FreshView/FreshView/README.md

# FreshView
Automated Plant Monitoring system
