FreshView/FreshView/Documentation/SympsosiumPosterFinal.pdf

# Hardware

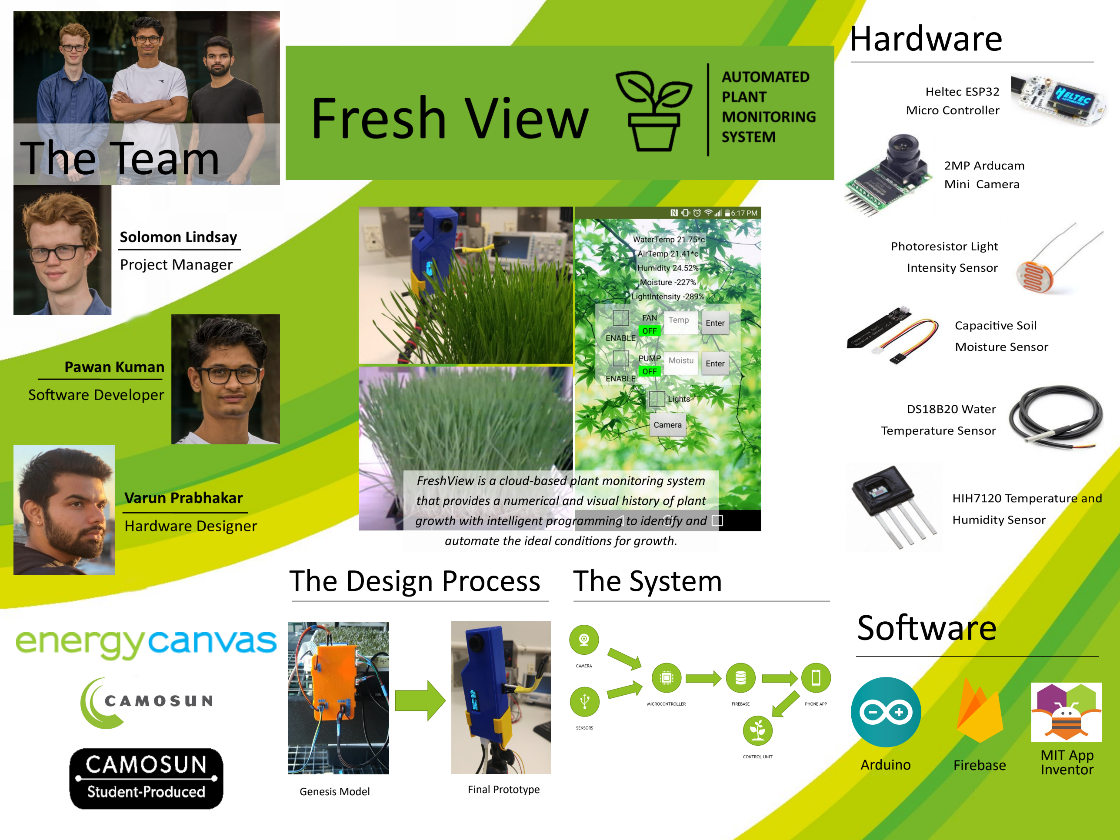
[picture p22: page 1]

# The Design Process

Genesis Model | Final Prototype

# Software

Arduino Firebase

MIT App
Inventor

# The System
