FreshView/FreshView/Documentation/FreshViewFinalPresentation.pdf

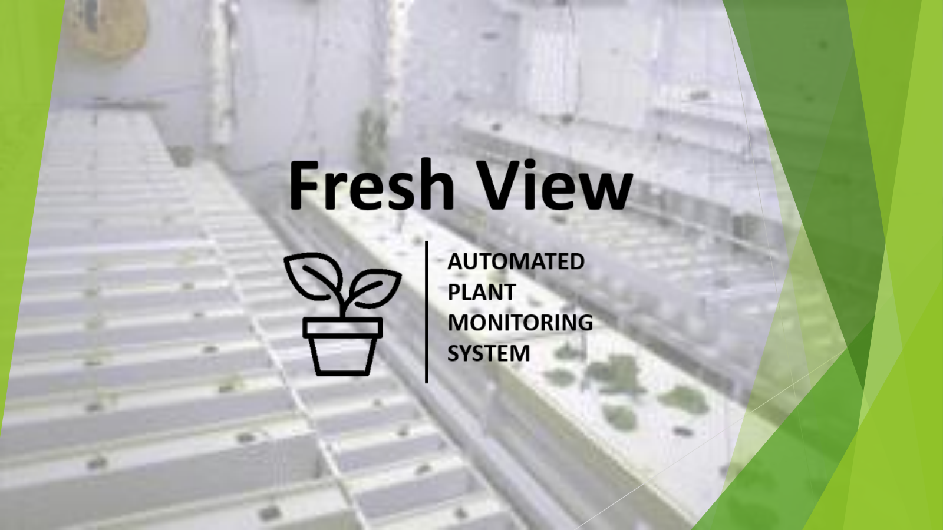
[picture p23: page 1]

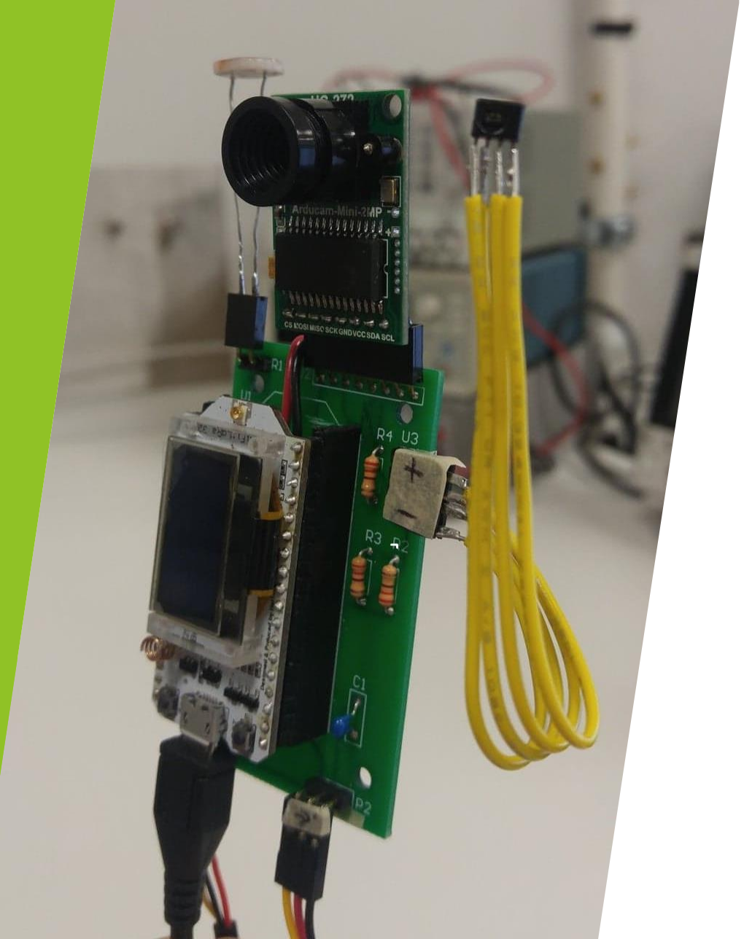
[picture p24: figure]

# The Project

Fresh View is a cloud-based plant monitoring system that provides numerical and visual data of plant growth to identify and automate the ideal growing conditions.

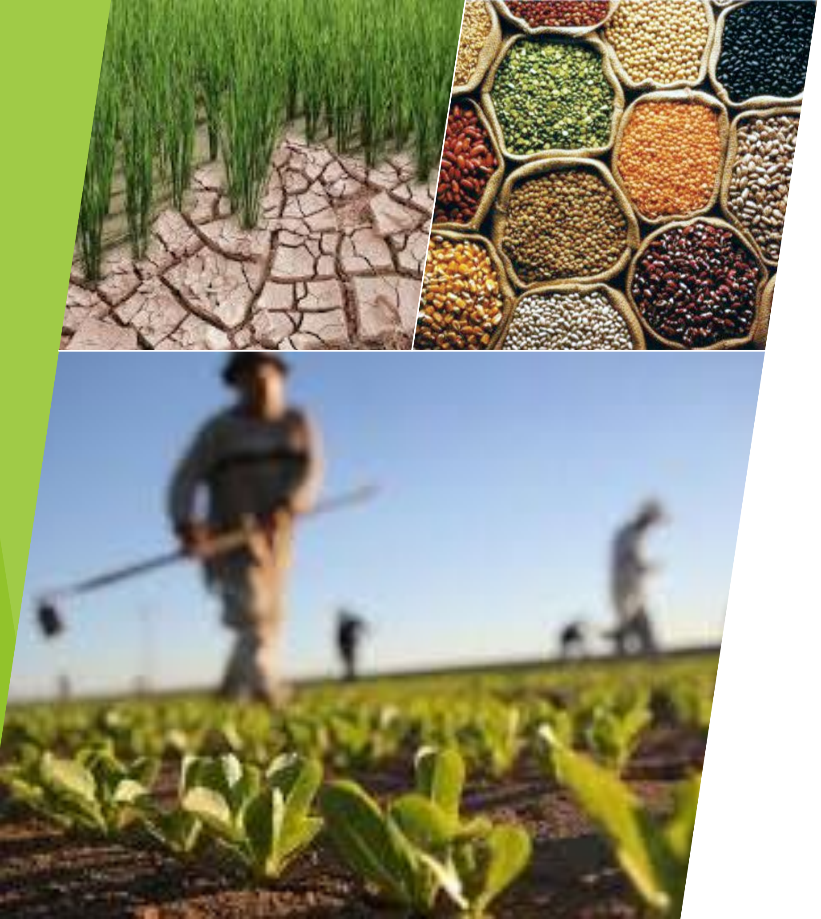
[picture p25: figure]
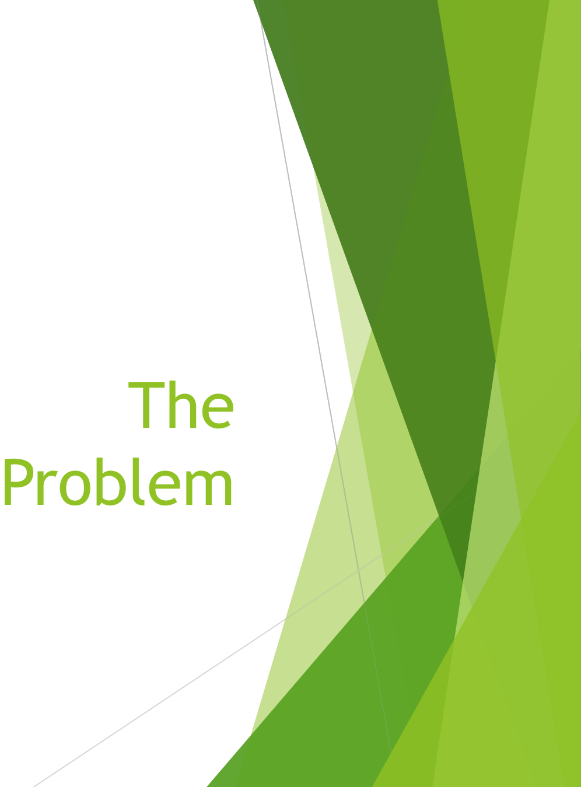
[picture p26: figure]
The Problem

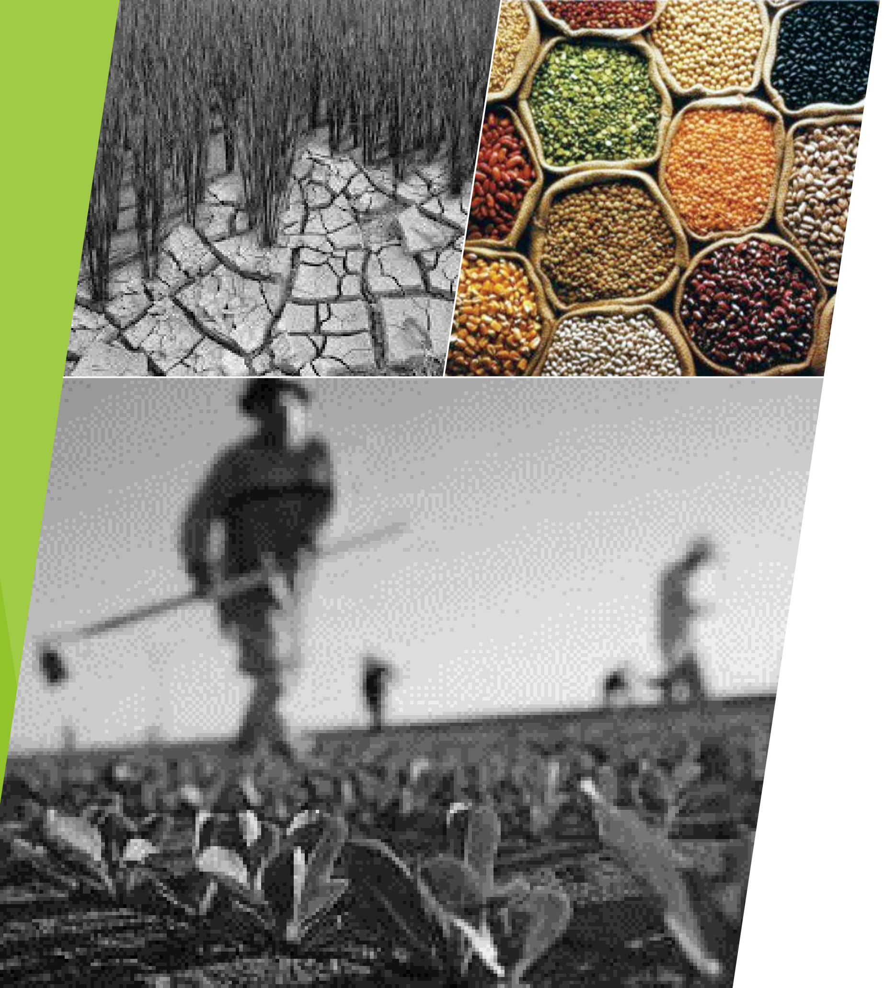
[picture p27: figure]

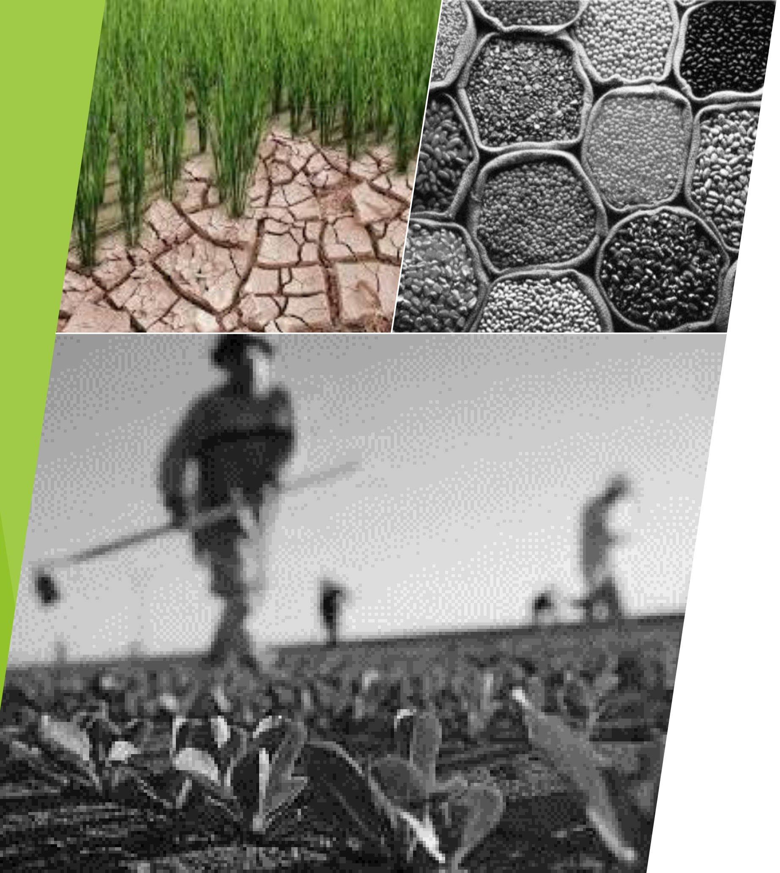
[picture p28: figure]

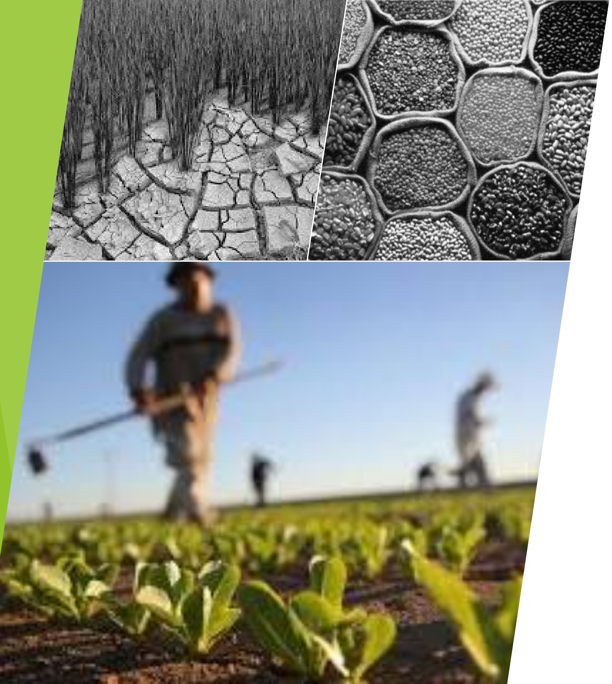
[picture p29: figure]

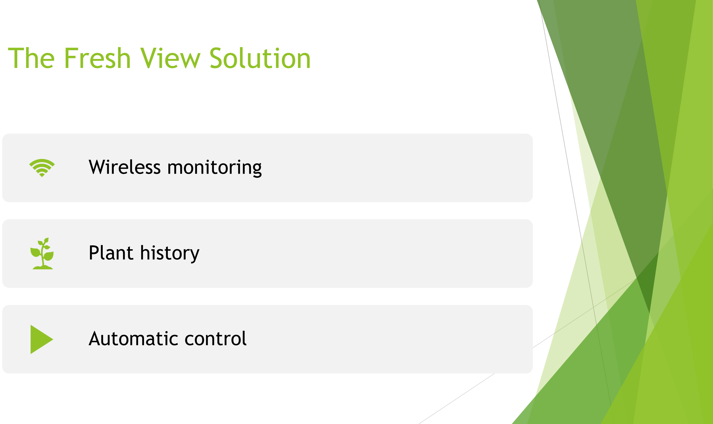
[picture p30: figure]
The Fresh View Solution; Wireless monitoring; Plant history; Automatic control

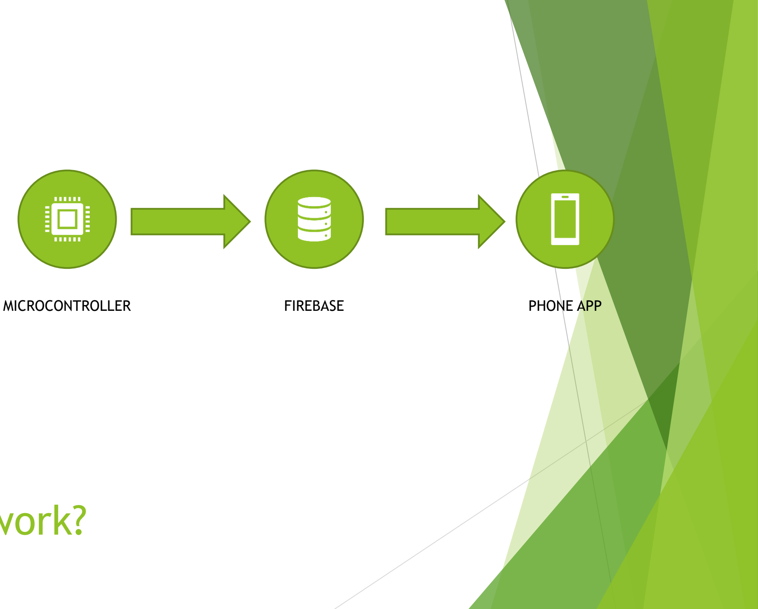
[picture p31: figure]
MICROCONTROLLER; FIREBASE; PHONE APP

# How does it work?

CAMERA

SENSORS

# How does it work?

CAMERA

SENSORS

# How does it work?

CAMERA

SENSORS

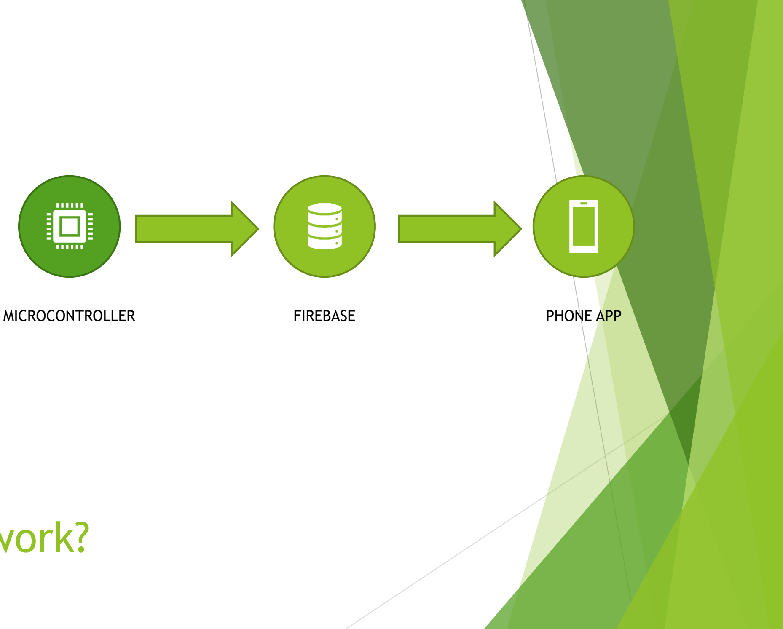
[picture p32: figure]
MICROCONTROLLER; FIREBASE; PHONE APP

# How does it work?

CAMERA

SENSORS

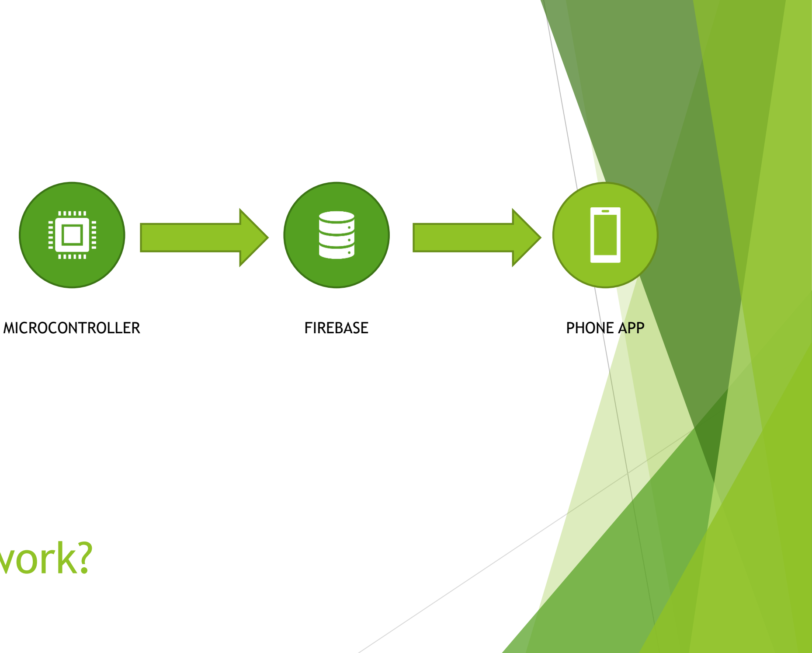
[picture p33: figure]
MICROCONTROLLER; FIREBASE; PHONE APP

# How does it work?

CAMERA

SENSORS

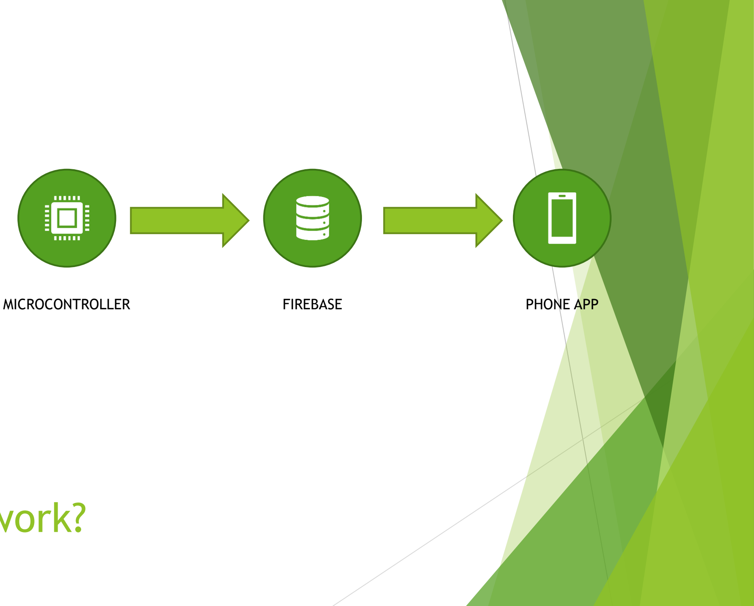
[picture p34: figure]
MICROCONTROLLER; FIREBASE; PHONE APP

# How does it work?

CAMERA

SENSORS

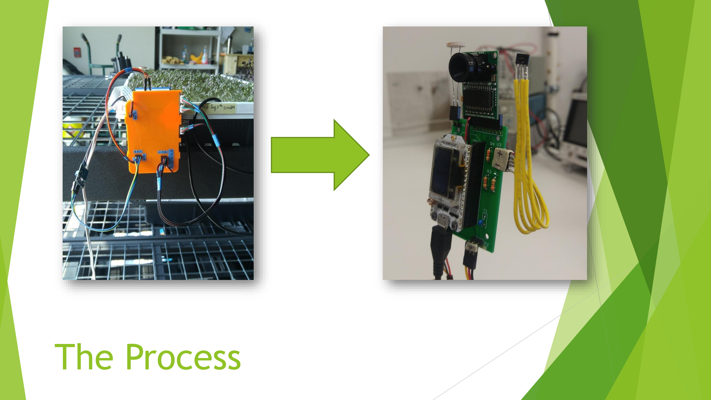
[picture p35: page 14]

# The Process

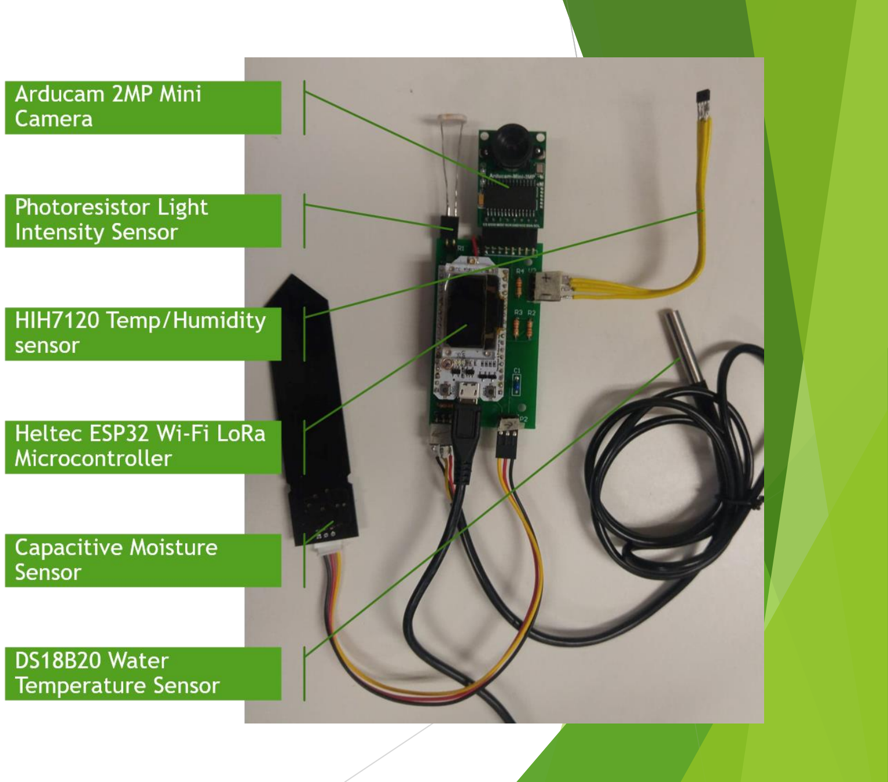
[picture p36: figure]

# Hardware

# Software

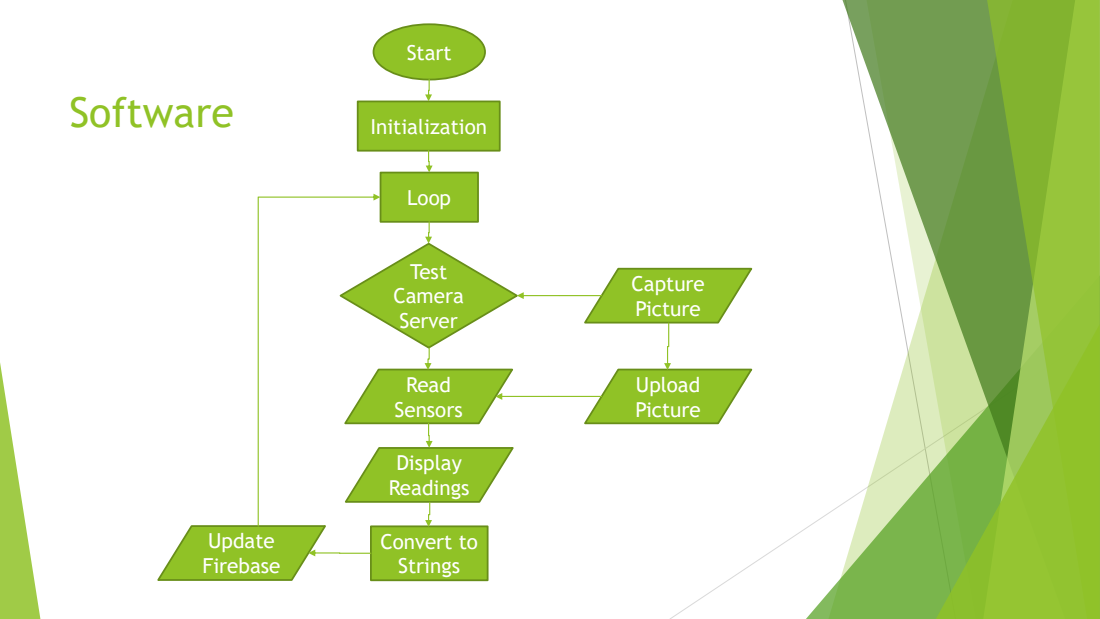
[picture p37: page 16]
Start; Initialization; Loop; Read Sensors; Display Readings; Update Firebase; Test Camera Server; Capture Picture; Upload Picture; Convert to Strings

# Software: Firebase to App

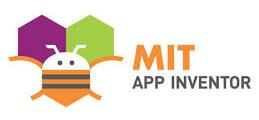
[picture p38: figure]

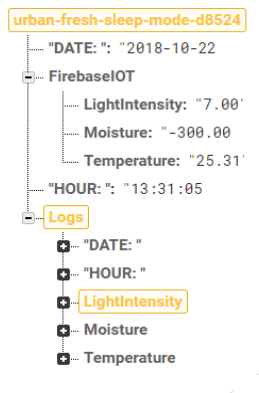
[picture p39: figure]

# Firebase

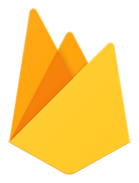
[picture p40: figure]

Firebase:
- A form of google cloud
- Real time database

# MIT App Inventor

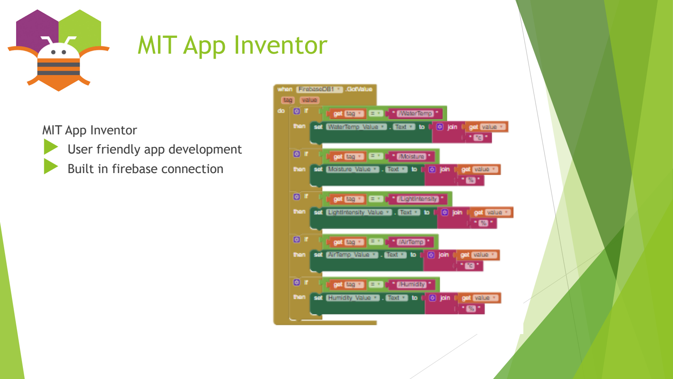
[picture p41: page 19]

MIT App Inventor
- User friendly app development
- Built in firebase connection

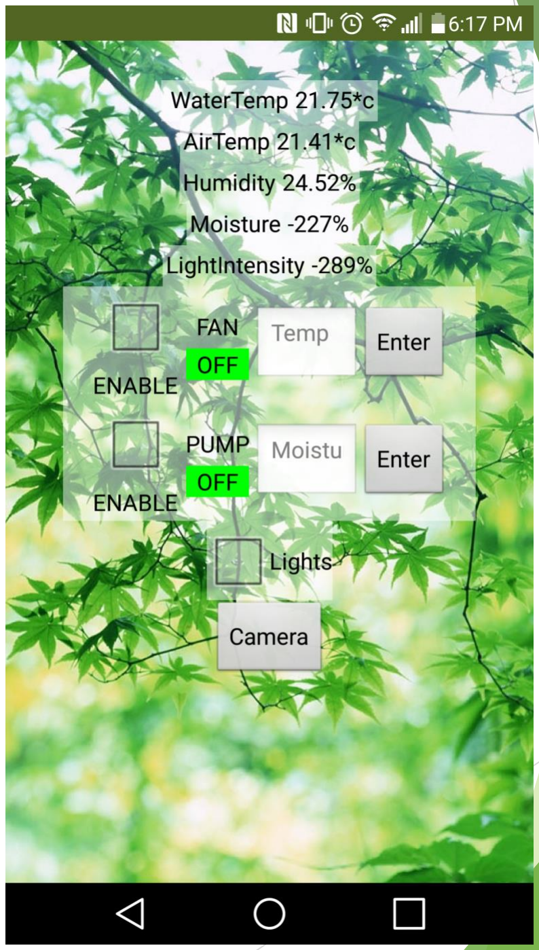
[picture p42: figure]

# App Interface

- User Friendly
- Regular information updates
- Pump, lights, and fan control
- Download as .apk for easy use

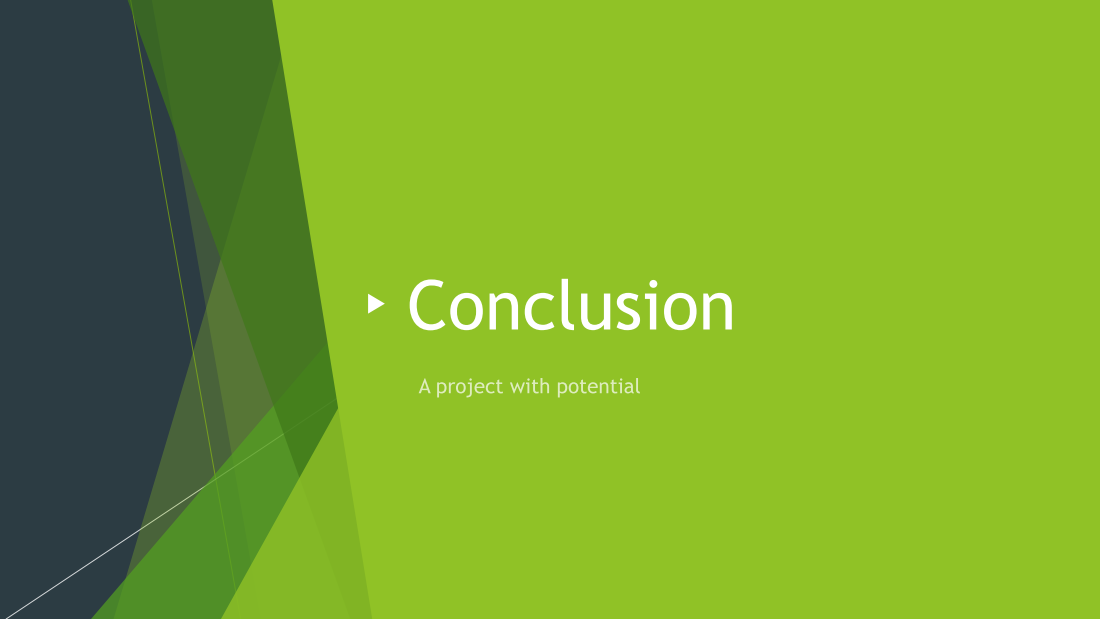
[picture p43: page 21]
Conclusion

# Thanks for Listening

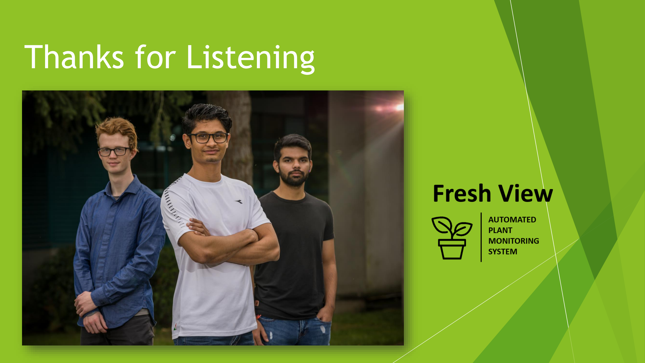
[picture p44: page 22]
