FreshView/FreshView/FreshViewBox v9.step

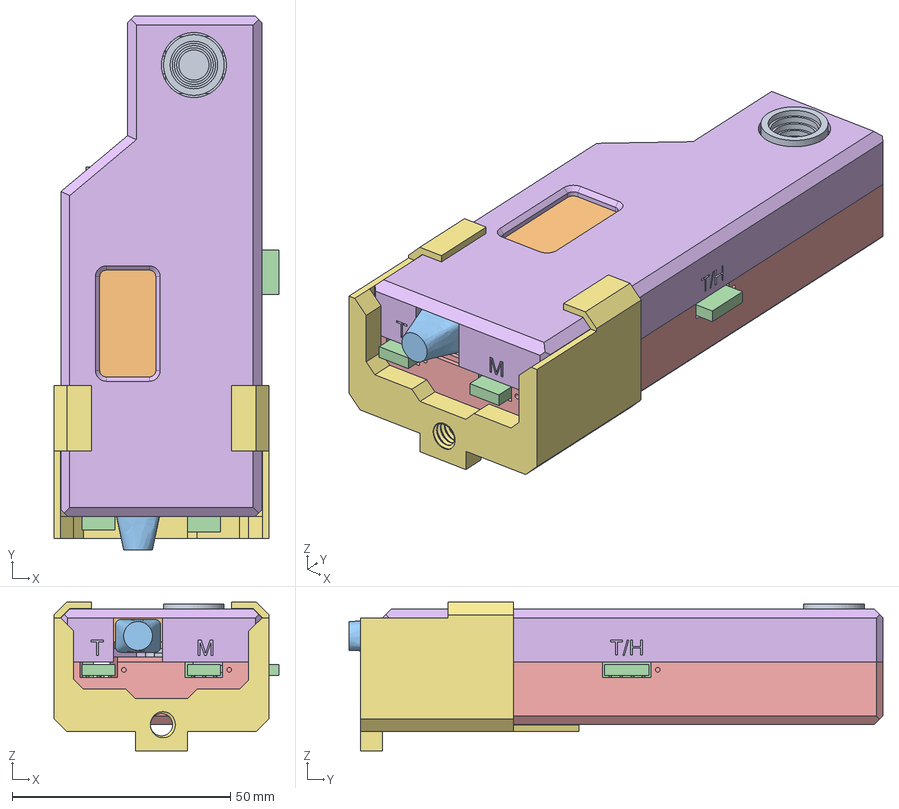
[picture p46: CAD file, 2018-12-17]
FreshViewBox v9.step
51.6 x 122.3 x 34.1 mm
Camera
ESP32
PCB
Enclosure
TripodClip
