FreshView/FreshView/Documentation/UserManual.pdf

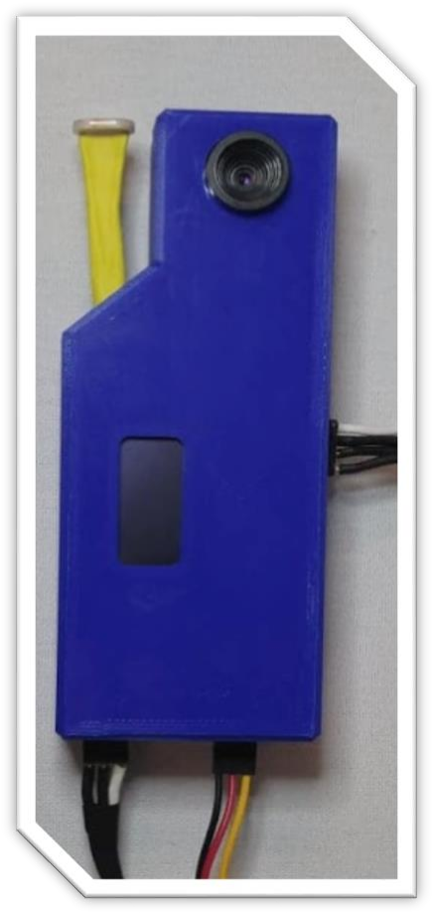
[picture p47: figure]

# FRESH VIEW

## User Manual

## Applied Research Project

Dec 7, 2018

## By: Urban Fresh

Pawan Kumar
Solomon Lindsay
Varun Prabhakar

## Recipient: Mel Dundas

1 | P a g e

## Table of Contents

# Introduction

Fresh View is an automated plant monitoring system which helps you to keep an eye on your plants. This product senses the kind of environment your plant is in and if connected to a control unit, removes any headache to actually take care of the plant. This is a complete guide about getting started with Fresh View. There are step by step instructions on how to set up the device and the mobile app.

Fresh View basically consist of two parts, first is the setting up the device in your planting area, and second is setting up the internet connection and app.

After setting the module you can log on to the firebase and see all the data taken by the module. Firebase is a very large storage system for data and pictures. You have access to this because if you want to look at the growth process of the plant and monitor the environment conditions of the plant growing up and keep record.

# Materials

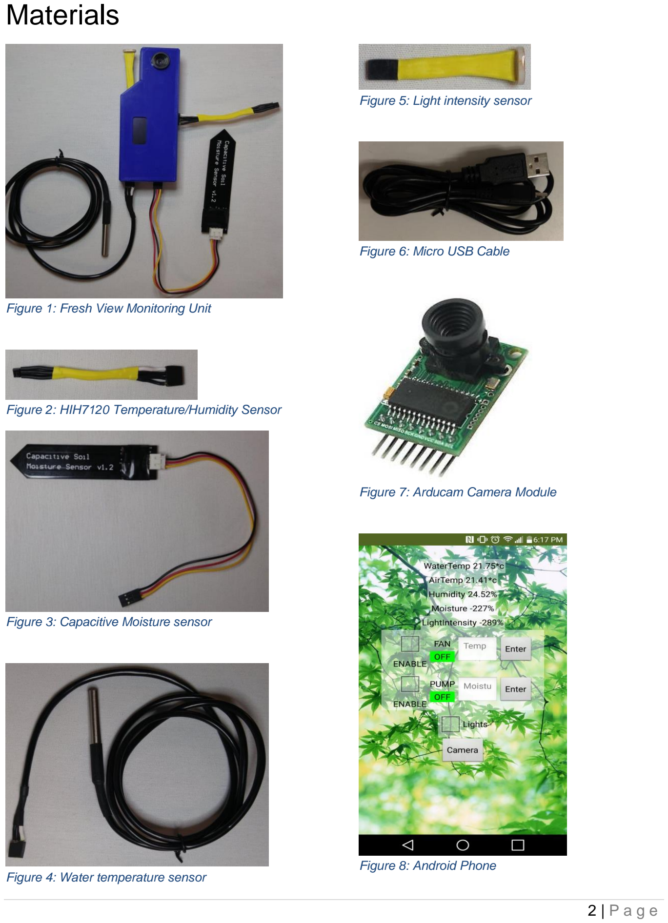
[picture p48: page 3]

Figure 1: Fresh View Monitoring Unit

Figure 2: HIH7120 Temperature/Humidity Sensor

Figure 3: Capacitive Moisture sensor

Figure 4: Water temperature sensor

Figure 5: Light intensity sensor

Figure 6: Micro USB Cable

Figure 7: Arducam Camera Module

Figure 8: Android Phone

# Instructions

## Set Up

### Hardware

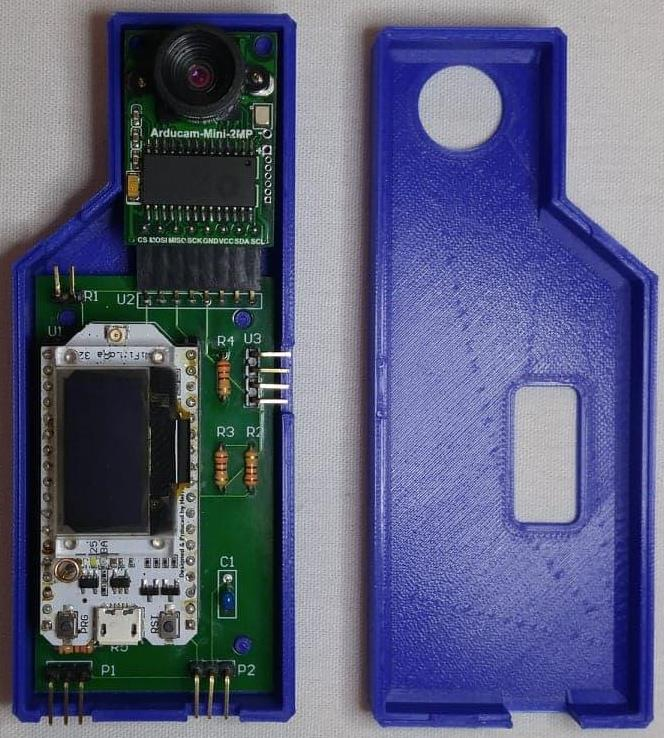
[picture p49: figure]
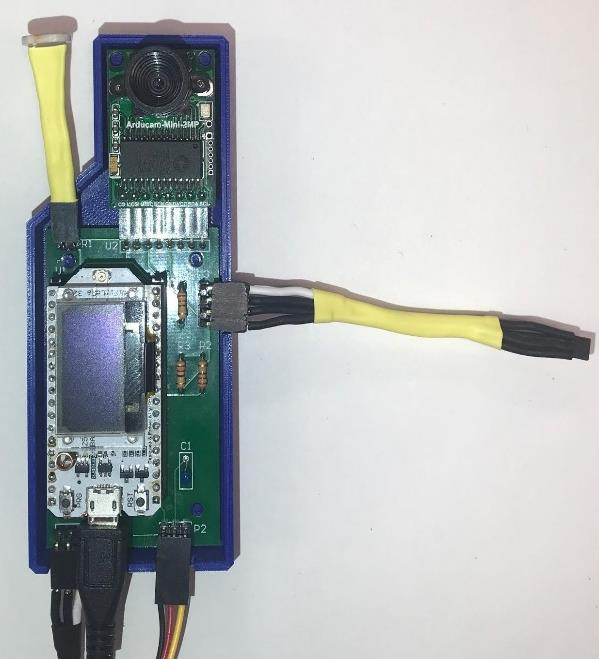
[picture p50: figure]

Figure 10: Monitor with Open Enclosure | Figure 9: Open Monitor with Connections

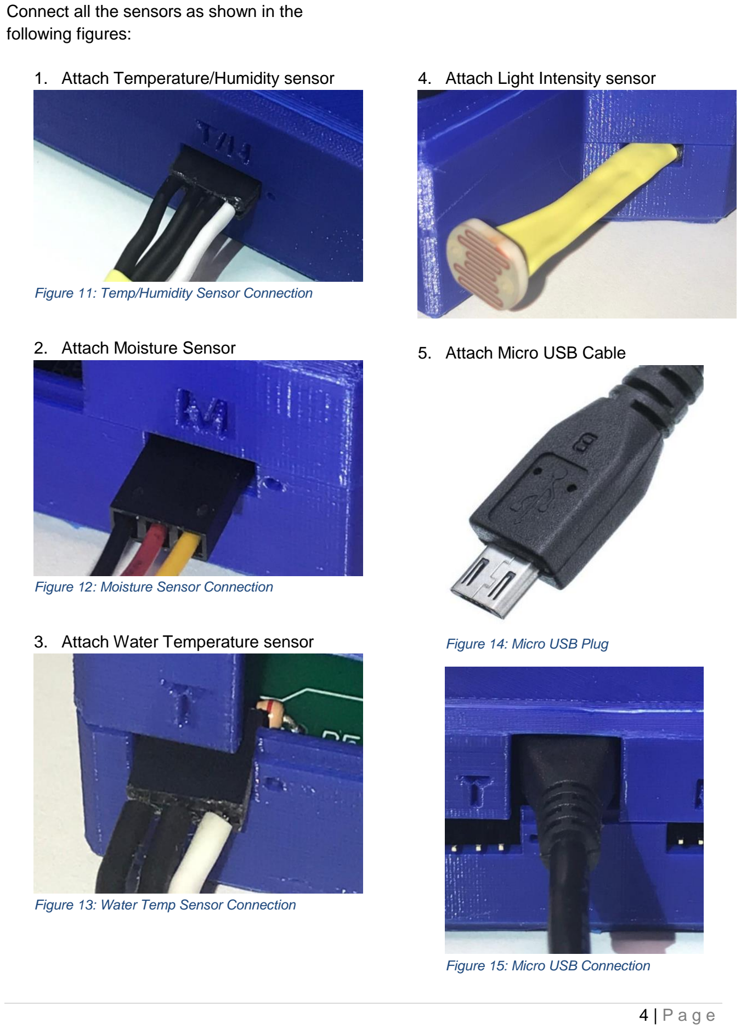
[picture p51: page 5]

Connect all the sensors as shown in the following figures:

1. Attach Temperature/Humidity sensor

Figure 11: Temp/Humidity Sensor Connection

2. Attach Moisture Sensor

Figure 12: Moisture Sensor Connection

3. Attach Water Temperature sensor

Figure 13: Water Temp Sensor Connection

4. Attach Light Intensity sensor
5. Attach Micro USB Cable

Figure 14: Micro USB Plug

Figure 15: Micro USB Connection

### Software

1. Go to www.arduino.cc.

Figure 16: Arduino Website

2. Download the latest version of arduino.

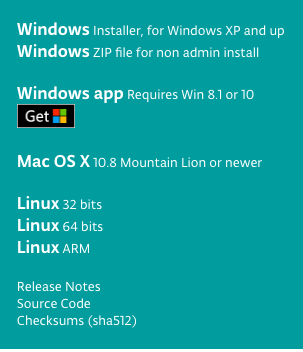
[picture p52: figure]

Figure 17: Arduino IDE Download

3. Install the arduino on your PC
4. Now, Download the FreshView zip package folder from Github.com.
5. To download the FreshView zip package

6. Search https://github.com/FreshView/FreshView

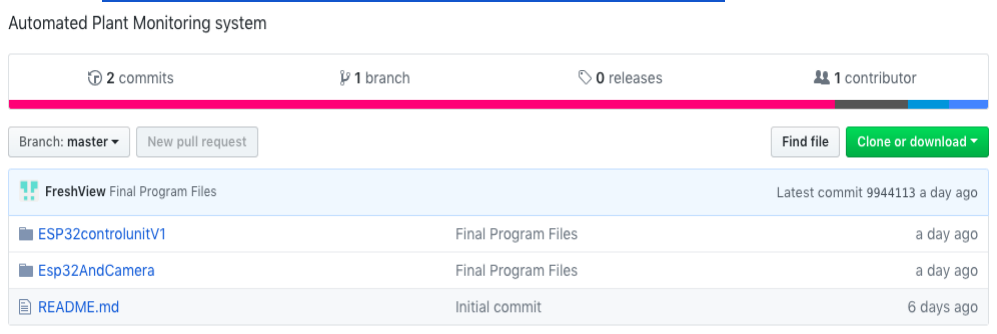
[picture p53: figure]

Figure 18: FreshView Github

7. Unzip the folder and open the ESP32 and Camera program under Arduino IDE once the package is downloaded
8. Connect the monitoring unit to your computer.
9. Change the Wifi address and password to your home network

Figure 19: Arduino Code SSID and Password

10. Save the program
11. Make sure you choose the right port before actually uploading the programming the unit.
12. Upload the code.
13. From the downloaded FreshView zip package
find FreshView[1].
14. Transfer the downloaded file to your android mobile phone and run the application.
15. Live data can be seen on the screen (Figure 20)
16. Enter your desired temperature and press enter.
17. If the desired temperature is less than the actual temperature, the fan will automatically turn on.
18. Enter the desired moisture content and press enter.
19. If the desired moisture content is less than the actual moisture content, the pump will turn on to irrigate the plants and increase the moisture level.

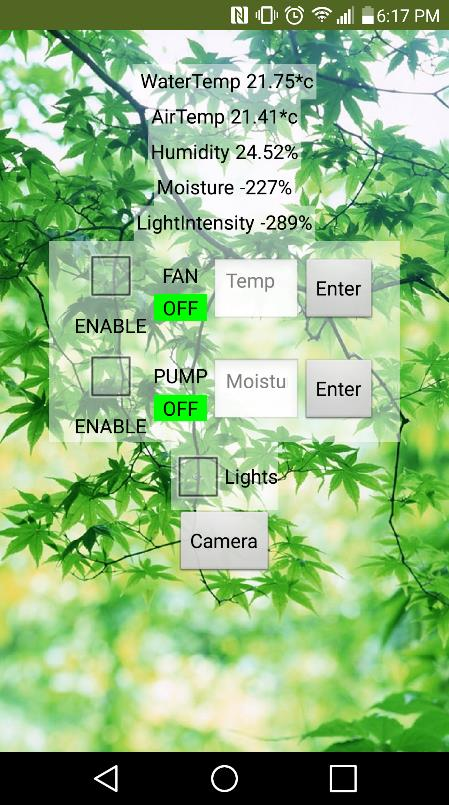
[picture p54: figure]

Figure 20: Fresh View App Interface

## Access to Online storage

1. Go to www.firebase.google.com

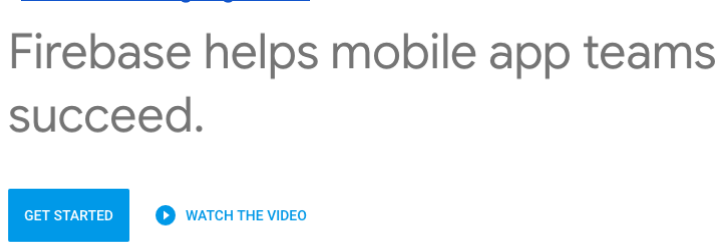
[picture p55: figure]

Figure 21: Firebase Website

2. Select “Get Started” and sign in or sign up using your google account.
3. Once you have been given access to the account, go to the console and choose the Urban Fresh Sleep Mode project. In this you will have access to the realtime database and logs of the project.

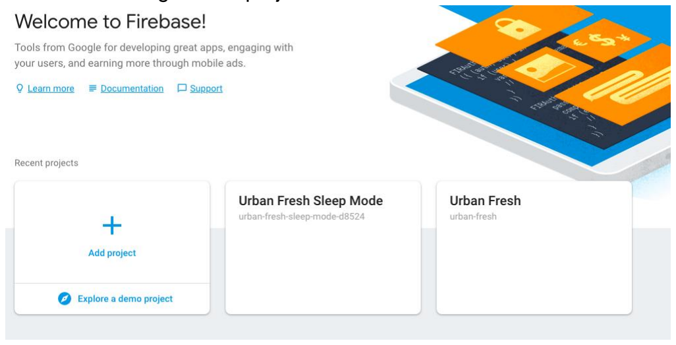
[picture p56: figure]

Figure 22: Firebase Console

# Conclusion

The Fresh View monitoring unit provides a unique solution to common growing needs. By provide the right information at the right time, Fresh View can help optimize yields, and prevent crop failure. The system is simple to set up and effortless to use. As long as the app is installed you will have access to essential plant data and an immediate visual link to the growing environment. If any issues arise in the setup or operation of this device, you can contact the Urban Fresh team at:

Pawan Kumar
pawancan59@gmail.com

Solomon Lindsay
sol.lauder.lindsay@gmail.com

Varun Prabhakar
varunprabhakar31@gmail.com
