FreshView/FreshView/MonitorUnitCode/ESP32WebServer.cpp

/*
  ESP32WebServer.cpp - Dead simple web-server.
  Supports only one simultaneous client, knows how to handle GET and POST.

  Copyright (c) 2014 Ivan Grokhotkov. All rights reserved.

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
  You should have received a copy of the GNU Lesser General Public
  License along with this library; if not, write to the Free Software
  Foundation, Inc., 51 Franklin St, Fifth Floor, Boston, MA  02110-1301  USA
  Modified 8 May 2015 by Hristo Gochkov (proper post and file upload handling)
*/


#include <Arduino.h>
#include <libb64/cencode.h>
#include "WiFiServer.h"
#include "WiFiClient.h"
#include "ESP32WebServer.h"
#include "FS.h"
#include "detail/RequestHandlersImpl.h"

//#define DEBUG_ESP_HTTP_SERVER
#ifdef DEBUG_ESP_PORT
#define DEBUG_OUTPUT DEBUG_ESP_PORT
#else
#define DEBUG_OUTPUT Serial
#endif

const char * AUTHORIZATION_HEADER = "Authorization";

ESP32WebServer::ESP32WebServer(IPAddress addr, int port)
: _server(addr, port)
, _currentMethod(HTTP_ANY)
, _currentVersion(0)
, _currentStatus(HC_NONE)
, _statusChange(0)
, _currentHandler(0)
, _firstHandler(0)
, _lastHandler(0)
, _currentArgCount(0)
, _currentArgs(0)
, _headerKeysCount(0)
, _currentHeaders(0)
, _contentLength(0)
, _chunked(false)
{
}

ESP32WebServer::ESP32WebServer(int port)
: _server(port)
, _currentMethod(HTTP_ANY)
, _currentVersion(0)
, _currentStatus(HC_NONE)
, _statusChange(0)
, _currentHandler(0)
, _firstHandler(0)
, _lastHandler(0)
, _currentArgCount(0)
, _currentArgs(0)
, _headerKeysCount(0)
, _currentHeaders(0)
, _contentLength(0)
, _chunked(false)
{
}

ESP32WebServer::~ESP32WebServer() {
  if (_currentHeaders)
    delete[]_currentHeaders;
  _headerKeysCount = 0;
  RequestHandler* handler = _firstHandler;
  while (handler) {
    RequestHandler* next = handler->next();
    delete handler;
    handler = next;
  }
  close();
}

void ESP32WebServer::begin() {
  _currentStatus = HC_NONE;
  _server.begin();
  if(!_headerKeysCount)
    collectHeaders(0, 0);
}

bool ESP32WebServer::authenticate(const char * username, const char * password){
  if(hasHeader(AUTHORIZATION_HEADER)){
    String authReq = header(AUTHORIZATION_HEADER);
    if(authReq.startsWith("Basic")){
      authReq = authReq.substring(6);
      authReq.trim();
      char toencodeLen = strlen(username)+strlen(password)+1;
      char *toencode = new char[toencodeLen + 1];
      if(toencode == NULL){
        authReq = String();
        return false;
      }
      char *encoded = new char[base64_encode_expected_len(toencodeLen)+1];
      if(encoded == NULL){
        authReq = String();
        delete[] toencode;
        return false;
      }
      sprintf(toencode, "%s:%s", username, password);
      if(base64_encode_chars(toencode, toencodeLen, encoded) > 0 && authReq.equals(encoded)){
        authReq = String();
        delete[] toencode;
        delete[] encoded;
        return true;
      }
      delete[] toencode;
      delete[] encoded;
    }
    authReq = String();
  }
  return false;
}

void ESP32WebServer::requestAuthentication(){
  sendHeader("WWW-Authenticate", "Basic realm=\"Login Required\"");
  send(401);
}

void ESP32WebServer::on(const String &uri, ESP32WebServer::THandlerFunction handler) {
  on(uri, HTTP_ANY, handler);
}

void ESP32WebServer::on(const String &uri, HTTPMethod method, ESP32WebServer::THandlerFunction fn) {
  on(uri, method, fn, _fileUploadHandler);
}

void ESP32WebServer::on(const String &uri, HTTPMethod method, ESP32WebServer::THandlerFunction fn, ESP32WebServer::THandlerFunction ufn) {
  _addRequestHandler(new FunctionRequestHandler(fn, ufn, uri, method));
}

void ESP32WebServer::addHandler(RequestHandler* handler) {
    _addRequestHandler(handler);
}

void ESP32WebServer::_addRequestHandler(RequestHandler* handler) {
    if (!_lastHandler) {
      _firstHandler = handler;
      _lastHandler = handler;
    }
    else {
      _lastHandler->next(handler);
      _lastHandler = handler;
    }
}

void ESP32WebServer::serveStatic(const char* uri, FS& fs, const char* path, const char* cache_header) {
    _addRequestHandler(new StaticRequestHandler(fs, path, uri, cache_header));
}

void ESP32WebServer::handleClient() {
  if (_currentStatus == HC_NONE) {
    WiFiClient client = _server.available();
    if (!client) {
      return;
    }

#ifdef DEBUG_ESP_HTTP_SERVER
    log_e("New client");
#endif

    _currentClient = client;
    _currentStatus = HC_WAIT_READ;
    _statusChange = millis();
  }

  if (!_currentClient.connected()) {
    _currentClient = WiFiClient();
    _currentStatus = HC_NONE;
    return;
  }

  // Wait for data from client to become available
  if (_currentStatus == HC_WAIT_READ) {
    if (!_currentClient.available()) {
      if (millis() - _statusChange > HTTP_MAX_DATA_WAIT) {
        _currentClient = WiFiClient();
        _currentStatus = HC_NONE;
      }
      yield();
      return;
    }

    if (!_parseRequest(_currentClient)) {
      _currentClient = WiFiClient();
      _currentStatus = HC_NONE;
      return;
    }
    _currentClient.setTimeout(HTTP_MAX_SEND_WAIT);
    _contentLength = CONTENT_LENGTH_NOT_SET;
    _handleRequest();

    if (!_currentClient.connected()) {
      _currentClient = WiFiClient();
      _currentStatus = HC_NONE;
      return;
    } else {
      _currentStatus = HC_WAIT_CLOSE;
      _statusChange = millis();
      return;
    }
  }

  if (_currentStatus == HC_WAIT_CLOSE) {
    if (millis() - _statusChange > HTTP_MAX_CLOSE_WAIT) {
      _currentClient = WiFiClient();
      _currentStatus = HC_NONE;
    } else {
      yield();
      return;
    }
  }
}

void ESP32WebServer::close() {
  _server.end();
}

void ESP32WebServer::stop() {
  close();
}

void ESP32WebServer::sendHeader(const String& name, const String& value, bool first) {
  String headerLine = name;
  headerLine += ": ";
  headerLine += value;
  headerLine += "\r\n";

  if (first) {
    _responseHeaders = headerLine + _responseHeaders;
  }
  else {
    _responseHeaders += headerLine;
  }
}

void ESP32WebServer::setContentLength(size_t contentLength) {
    _contentLength = contentLength;
}

void ESP32WebServer::_prepareHeader(String& response, int code, const char* content_type, size_t contentLength) {
    response = "HTTP/1."+String(_currentVersion)+" ";
    response += String(code);
    response += " ";
    response += _responseCodeToString(code);
    response += "\r\n";

    if (!content_type)
        content_type = "text/html";

    sendHeader("Content-Type", content_type, true);
    if (_contentLength == CONTENT_LENGTH_NOT_SET) {
        sendHeader("Content-Length", String(contentLength));
    } else if (_contentLength != CONTENT_LENGTH_UNKNOWN) {
        sendHeader("Content-Length", String(_contentLength));
    } else if(_contentLength == CONTENT_LENGTH_UNKNOWN && _currentVersion){ //HTTP/1.1 or above client
      //let's do chunked
      _chunked = true;
      sendHeader("Accept-Ranges","none");
      sendHeader("Transfer-Encoding","chunked");
    }
    sendHeader("Connection", "close");
    sendHeader("Access-Control-Allow-Origin", "*");
    response += _responseHeaders;
    response += "\r\n";
    _responseHeaders = String();
}

void ESP32WebServer::send(int code, const char* content_type, const String& content) {
    String header;
    // Can we asume the following?
    //if(code == 200 && content.length() == 0 && _contentLength == CONTENT_LENGTH_NOT_SET)
    //  _contentLength = CONTENT_LENGTH_UNKNOWN;
    _prepareHeader(header, code, content_type, content.length());
    _currentClient.write(header.c_str(), header.length());
    if(content.length())
      sendContent(content);
}

void ESP32WebServer::send_P(int code, PGM_P content_type, PGM_P content) {
    size_t contentLength = 0;

    if (content != NULL) {
        contentLength = strlen_P(content);
    }

    String header;
    char type[64];
    memccpy_P((void*)type, (PGM_VOID_P)content_type, 0, sizeof(type));
    _prepareHeader(header, code, (const char* )type, contentLength);
    _currentClient.write(header.c_str(), header.length());
    sendContent_P(content);
}

void ESP32WebServer::send_P(int code, PGM_P content_type, PGM_P content, size_t contentLength) {
    String header;
    char type[64];
    memccpy_P((void*)type, (PGM_VOID_P)content_type, 0, sizeof(type));
    _prepareHeader(header, code, (const char* )type, contentLength);
    sendContent(header);
    sendContent_P(content, contentLength);
}

void ESP32WebServer::send(int code, char* content_type, const String& content) {
  send(code, (const char*)content_type, content);
}

void ESP32WebServer::send(int code, const String& content_type, const String& content) {
  send(code, (const char*)content_type.c_str(), content);
}

void ESP32WebServer::sendContent(const String& content) {
  const char * footer = "\r\n";
  size_t len = content.length();
  if(_chunked) {
    char * chunkSize = (char *)malloc(11);
    if(chunkSize){
      sprintf(chunkSize, "%x%s", len, footer);
      _currentClient.write(chunkSize, strlen(chunkSize));
      free(chunkSize);
    }
  }
  _currentClient.write(content.c_str(), len);
  if(_chunked){
    _currentClient.write(footer, 2);
  }
}

void ESP32WebServer::sendContent_P(PGM_P content) {
  sendContent_P(content, strlen_P(content));
}

void ESP32WebServer::sendContent_P(PGM_P content, size_t size) {
  const char * footer = "\r\n";
  if(_chunked) {
    char * chunkSize = (char *)malloc(11);
    if(chunkSize){
      sprintf(chunkSize, "%x%s", size, footer);
      _currentClient.write(chunkSize, strlen(chunkSize));
      free(chunkSize);
    }
  }
  size_t chunkSize = 20;
  int idx = 0;
  while(size != 0){
      if(size < chunkSize){
        _currentClient.write(&content[idx], size);
        size = 0;
      } else {
        _currentClient.write(&content[idx], chunkSize);
        size -= chunkSize;
        idx += chunkSize;
      }
    yield();
  }
  if(_chunked){
    _currentClient.write(footer, 2);
  }
}


String ESP32WebServer::arg(String name) {
  for (int i = 0; i < _currentArgCount; ++i) {
    if ( _currentArgs[i].key == name )
      return _currentArgs[i].value;
  }
  return String();
}

String ESP32WebServer::arg(int i) {
  if (i < _currentArgCount)
    return _currentArgs[i].value;
  return String();
}

String ESP32WebServer::argName(int i) {
  if (i < _currentArgCount)
    return _currentArgs[i].key;
  return String();
}

int ESP32WebServer::args() {
  return _currentArgCount;
}

bool ESP32WebServer::hasArg(String  name) {
  for (int i = 0; i < _currentArgCount; ++i) {
    if (_currentArgs[i].key == name)
      return true;
  }
  return false;
}


String ESP32WebServer::header(String name) {
  for (int i = 0; i < _headerKeysCount; ++i) {
    if (_currentHeaders[i].key.equalsIgnoreCase(name))
      return _currentHeaders[i].value;
  }
  return String();
}

void ESP32WebServer::collectHeaders(const char* headerKeys[], const size_t headerKeysCount) {
  _headerKeysCount = headerKeysCount + 1;
  if (_currentHeaders)
     delete[]_currentHeaders;
  _currentHeaders = new RequestArgument[_headerKeysCount];
  _currentHeaders[0].key = AUTHORIZATION_HEADER;
  for (int i = 1; i < _headerKeysCount; i++){
    _currentHeaders[i].key = headerKeys[i-1];
  }
}

String ESP32WebServer::header(int i) {
  if (i < _headerKeysCount)
    return _currentHeaders[i].value;
  return String();
}

String ESP32WebServer::headerName(int i) {
  if (i < _headerKeysCount)
    return _currentHeaders[i].key;
  return String();
}

int ESP32WebServer::headers() {
  return _headerKeysCount;
}

bool ESP32WebServer::hasHeader(String name) {
  for (int i = 0; i < _headerKeysCount; ++i) {
    if ((_currentHeaders[i].key.equalsIgnoreCase(name)) &&  (_currentHeaders[i].value.length() > 0))
      return true;
  }
  return false;
}

String ESP32WebServer::hostHeader() {
  return _hostHeader;
}

void ESP32WebServer::onFileUpload(THandlerFunction fn) {
  _fileUploadHandler = fn;
}

void ESP32WebServer::onNotFound(THandlerFunction fn) {
  _notFoundHandler = fn;
}

void ESP32WebServer::_handleRequest() {
  bool handled = false;
  if (!_currentHandler){
#ifdef DEBUG_ESP_HTTP_SERVER
    DEBUG_OUTPUT.println("request handler not found");
#endif
  }
  else {
    handled = _currentHandler->handle(*this, _currentMethod, _currentUri);
#ifdef DEBUG_ESP_HTTP_SERVER
    if (!handled) {
      DEBUG_OUTPUT.println("request handler failed to handle request");
    }
#endif
  }

  if (!handled) {
    if(_notFoundHandler) {
      _notFoundHandler();
    }
    else {
      send(404, "text/plain", String("Not found: ") + _currentUri);
    }
  }

  _currentUri = String();
}

String ESP32WebServer::_responseCodeToString(int code) {
  switch (code) {
    case 100: return F("Continue");
    case 101: return F("Switching Protocols");
    case 200: return F("OK");
    case 201: return F("Created");
    case 202: return F("Accepted");
    case 203: return F("Non-Authoritative Information");
    case 204: return F("No Content");
    case 205: return F("Reset Content");
    case 206: return F("Partial Content");
    case 300: return F("Multiple Choices");
    case 301: return F("Moved Permanently");
    case 302: return F("Found");
    case 303: return F("See Other");
    case 304: return F("Not Modified");
    case 305: return F("Use Proxy");
    case 307: return F("Temporary Redirect");
    case 400: return F("Bad Request");
    case 401: return F("Unauthorized");
    case 402: return F("Payment Required");
    case 403: return F("Forbidden");
    case 404: return F("Not Found");
    case 405: return F("Method Not Allowed");
    case 406: return F("Not Acceptable");
    case 407: return F("Proxy Authentication Required");
    case 408: return F("Request Time-out");
    case 409: return F("Conflict");
    case 410: return F("Gone");
    case 411: return F("Length Required");
    case 412: return F("Precondition Failed");
    case 413: return F("Request Entity Too Large");
    case 414: return F("Request-URI Too Large");
    case 415: return F("Unsupported Media Type");
    case 416: return F("Requested range not satisfiable");
    case 417: return F("Expectation Failed");
    case 500: return F("Internal Server Error");
    case 501: return F("Not Implemented");
    case 502: return F("Bad Gateway");
    case 503: return F("Service Unavailable");
    case 504: return F("Gateway Time-out");
    case 505: return F("HTTP Version not supported");
    default:  return "";
  }
}
